open-dynamic-robot-initiative/power-board/firmware/powerboard/Core/Src/main.c

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
/* Includes ------------------------------------------------------------------*/
#include "main.h"

/* USER CODE BEGIN Includes */
#include "ws2812_bitbang.h"
#include "ina239.h"
#include "spi_com.h"
/* USER CODE END Includes */

SPI_HandleTypeDef hspi1;
SPI_HandleTypeDef hspi2;
DMA_HandleTypeDef hdma_spi1_tx;
DMA_HandleTypeDef hdma_spi1_rx;

TIM_HandleTypeDef htim3;

/* USER CODE BEGIN PV */
//                   |  8  |  8  |     16    |     16    |            32         |   16      |
//                   |0xaa | cpt |    vbus   |   vshunt  |          energy       |  CRC      |  Power board Sensor message
#define INIT_TX_BUF  {0xaa, 0xa0, 0xaa, 0xaa, 0xaa, 0xaa, 0xaa, 0xaa, 0xaa, 0xaa, 0xaa, 0x00}

//                   |  8  |  8  |     16    |     16    |    16     |    16     |   16      |
//                   |0xbb | cmd |  vbusmax  | vshuntmax |window_time|           |  CRC      |  Power board Command message
#define INIT_RX_BUF  {0xbb, 0x00, 0x00, 0x00, 0x00, 0x00, 0x00, 0x00, 0x00, 0x00, 0x00, 0x00}

//cmd:
//0x00 no command
//0x01 turn off power
//0x02 turn off power and logic
//0x03 turn on power
//0xC0-0xFF overwrite LED Color using 6bits [1 1 R R G G B B]

uint8_t TX_buffer_SPI1[12] = INIT_TX_BUF;
uint8_t RX_buffer_SPI1[12] = INIT_RX_BUF;

uint8_t sensor_frame[12] = INIT_TX_BUF;
uint8_t command_frame[12] = INIT_RX_BUF;


/* USER CODE END PV */

void SystemClock_Config(void);
static void MX_GPIO_Init(void);
static void MX_DMA_Init(void);
static void MX_SPI1_Init(void);
static void MX_SPI2_Init(void);
static void MX_TIM3_Init(void);
/**
  * @brief  The application entry point.
  * @retval int
  */
int main(void)
{
  /* MCU Configuration--------------------------------------------------------*/

  /* Reset of all peripherals, Initializes the Flash interface and the Systick. */
  HAL_Init();

  /* Configure the system clock */
  SystemClock_Config();

  /* Initialize all configured peripherals */
  MX_GPIO_Init();
  MX_DMA_Init();
  MX_SPI1_Init();
  MX_SPI2_Init();
  MX_TIM3_Init();
  /* USER CODE BEGIN 2 */
  HAL_TIM_Base_Start(&htim3);
  HAL_GPIO_WritePin(GPIOA, GPIO_PIN_3, GPIO_PIN_SET); //Enable the DC/DC converter even if user stop pressing "ON"
  HAL_Delay(100);
  HAL_GPIO_WritePin(GPIOA, GPIO_PIN_1, GPIO_PIN_SET); //Enable Power Output
  /* USER CODE END 2 */

  /* Infinite loop */
  /* USER CODE BEGIN WHILE */
  uint16_t vbus=0;
  int16_t vshunt=0;

  int16_t  vshuntValueThreshold = 25 * 800; // 25A * 800  ---  with 800=(4e-3/5e-6)=4mOhm / (5uV/LSB)  ---   40A is the maximum
  uint16_t vbusValueThreshold   = 0; //TODO
  int32_t vshuntTimeThreshold = 100*1000; //100ms
  int32_t vbusTimeThreshold   = 100*1000; //100ms

  int32_t periodVshuntAboveThreshold=0;
  int32_t periodVbusAboveThreshold=0;


  char errorOverCurrent = 0;
  char errorUnderVoltage = 0;

  union {
    float asFloat;
    unsigned char asBytes[4];
  } energy={.asFloat=0.0f};

  uint16_t time = __HAL_TIM_GET_COUNTER(&htim3);
  uint16_t time_diff = 0;
  uint16_t sample_time;
  uint16_t last_sample_time = 0;
  uint16_t dt;
  uint16_t crc;
  uint8_t red = 0;

  int i;
  uint8_t cpt=0;
  last_sample_time=__HAL_TIM_GET_COUNTER(&htim3);

  //Prepare the First SPI communication. Next ones will be triggered by the DMA IRQ
  HAL_SPI_TransmitReceive_DMA(&hspi1, TX_buffer_SPI1, RX_buffer_SPI1, 12);

  while (1) //This loop should never be executed in more that 65ms for the energy integration to stay valid
  {
	  cpt++;
	  //HAL_SPI_TransmitReceive_DMA(&hspi1, TX_buffer_SPI1, RX_buffer_SPI1, 12);
	  time_diff = __HAL_TIM_GET_COUNTER(&htim3) - time ;
	  if (time_diff >= 1000) //Blink LED in RED
	  {
		  time = __HAL_TIM_GET_COUNTER(&htim3);
		  red = 0xff * (red==0);
		  bitbangledRGB(red,0,0);
	  }
	  sample_time = __HAL_TIM_GET_COUNTER(&htim3); //time in microseconds
	  dt = sample_time - last_sample_time; //(all in uint16, so no overflow problems here)
	  last_sample_time = sample_time;
	  vbus = read_register16_INA239(hspi2,REG_INA_VBUS);
	  vshunt = -read_register16_INA239(hspi2,REG_INA_VSHUNT);
	  //power = read_register24_INA239(hspi2,REG_INA_POWER);

	  //Over current detection
	  if (vshunt > vshuntValueThreshold || vshunt < -vshuntValueThreshold)
	  {
		  periodVshuntAboveThreshold += dt;
	  }
	  else
	  {
		  if (periodVshuntAboveThreshold>dt)
		  {
			  periodVshuntAboveThreshold -= dt;
		  }
		  else
		  {
			  periodVshuntAboveThreshold = 0;
		  }
	  }
	  errorOverCurrent = (periodVshuntAboveThreshold > vshuntTimeThreshold);

	  //Under voltage detection
	  if (vbus < vbusValueThreshold)
	  {
		  periodVbusAboveThreshold += dt;
	  }
	  else
	  {
		  if (periodVbusAboveThreshold>dt)
		  {
			  periodVbusAboveThreshold -= dt;
		  }
		  else
		  {
			  periodVbusAboveThreshold = 0;
		  }
	  }
	  errorUnderVoltage = (periodVbusAboveThreshold > vbusTimeThreshold);






	  energy.asFloat = energy.asFloat + 1e-6 * dt*vbus*vshunt; //todo manage the units
	  sensor_frame[1] = cpt;
	  sensor_frame[2] = (vbus>>8)&0xff;
	  sensor_frame[3] = vbus&0xff;
	  sensor_frame[4] = (vshunt>>8)&0xff;
	  sensor_frame[5] = vshunt&0xff;
	  sensor_frame[6] = energy.asBytes[3];
	  sensor_frame[7] = energy.asBytes[2];
	  sensor_frame[8] = energy.asBytes[1];
	  sensor_frame[9] = energy.asBytes[0];
	  crc = crc16_ccitt(sensor_frame, 10);
	  sensor_frame[10] = (crc>>8)&0xff;
	  sensor_frame[11] = crc&0xff;
	  if (HAL_GPIO_ReadPin(GPIOA, GPIO_PIN_4)) //No SPI communication running, lets copy the buffers
	  {
		  for(i=1;i<12;i++)
		  {
			  TX_buffer_SPI1[i] = sensor_frame[i];
			  command_frame[i] = RX_buffer_SPI1[i];
		  }
	  }
	  //HAL_Delay(1);

    /* USER CODE END WHILE */

    /* USER CODE BEGIN 3 */
  }
  /* USER CODE END 3 */
}

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
/* USER CODE BEGIN 4 */
void HAL_GPIO_EXTI_Callback(uint16_t GPIO_Pin)
{
	if (GPIO_Pin == SPI1_CS_Pin)
	{
		if (HAL_GPIO_ReadPin(SPI1_CS_GPIO_Port,SPI1_CS_Pin) == GPIO_PIN_SET)
		{
			HAL_SPI_Abort(&hspi1);
			HAL_SPI_TransmitReceive_DMA(&hspi1, TX_buffer_SPI1, RX_buffer_SPI1, 12);
		}
	}
}




void HAL_SPI_TxRxCpltCallback(SPI_HandleTypeDef *hspi)
{
	if (hspi == &hspi1)
	{

	}
}
/* USER CODE END 4 */
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
