open-dynamic-robot-initiative/power-board/firmware/powerboard/powerboard.ioc

Mcu.UserName=STM32F103C8Tx
PD0-OSC_IN.Signal=RCC_OSC_IN
PB13.Signal=SPI2_SCK
PB15.Signal=SPI2_MOSI
PD1-OSC_OUT.Signal=RCC_OSC_OUT
PA13.Signal=SYS_JTMS-SWDIO
PA1.Signal=GPIO_Output
PB14.Signal=SPI2_MISO
PA5.Signal=SPI1_SCK
PA1.GPIO_Label=POWER_ENA
PB3.Signal=GPIO_Output
PA4.Signal=GPXTI4
PA6.Signal=SPI1_MISO
PA14.Signal=SYS_JTCK-SWCLK
PA4.GPIO_Label=SPI1_CS
PB12.Signal=GPIO_Output
PA3.GPIO_Label=DCDC_ENA
PA3.Signal=GPIO_Output
PA7.Signal=SPI1_MOSI
PB3.GPIO_Label=LED
