open-dynamic-robot-initiative/power-board/firmware/powerboard/Core/Inc/main.h

#define POWER_ENA_Pin GPIO_PIN_1
#define POWER_ENA_GPIO_Port GPIOA
#define DCDC_ENA_Pin GPIO_PIN_3
#define DCDC_ENA_GPIO_Port GPIOA
#define SPI1_CS_Pin GPIO_PIN_4
#define SPI1_CS_GPIO_Port GPIOA
#define SPI1_CS_EXTI_IRQn EXTI4_IRQn
#define LED_Pin GPIO_PIN_3
#define LED_GPIO_Port GPIOB
