open-dynamic-robot-initiative/power-board/firmware/powerboard/Core/Inc/spi_com.h

/*
 * spi_com.h
 *
 *  Created on: Jul 6, 2021
 *      Author: tflayols
 */

#ifndef SRC_SPI_COM_H_
#define SRC_SPI_COM_H_
#include <stdint.h>

uint16_t crc16_ccitt(uint8_t * data, int len);


#endif /* SRC_SPI_COM_H_ */
