open-dynamic-robot-initiative/power-board/(commit log)

2021-02-02 Add power connector and INA229
    [odri-power-board.kicad_pcb, odri-power-board.sch]
2021-02-09 add dc-dc converter
    [odri-power-board.kicad_pcb, odri-power-board.sch]
2021-02-09 WIP, Add MCU, SW, Transistor, LDO...
    [odri-power-board.kicad_pcb, odri-power-board.sch]
2021-02-09 add template, WIP..
    [odri-power-board.kicad_pcb, odri-power-board.sch]
2021-02-09 Add LTC7001 Mosfet Driver
    [odri-power-board.kicad_pcb, odri-power-board.sch]
2021-02-09 add legends, reset circuit, clean schematic, WIP..
    [odri-power-board.kicad_pcb, odri-power-board.sch]
2021-03-10 first version of complete schematic
    [odri-power-board.kicad_pcb, odri-power-board.sch]
2021-03-10 Add all footprint, wip: SWD connector, oscillator, NC E-stop
    [odri-power-board.kicad_pcb, odri-power-board.sch]
2021-03-17 Finalize SWD connector, Update MCU for dual SPI and more GPIO, wip
    [odri-power-board.kicad_pcb, odri-power-board.sch]
2021-03-17 update pcb
    [odri-power-board.kicad_pcb]
2021-03-17 add WS2812 LED
    [odri-power-board.kicad_pcb, odri-power-board.sch]
2021-03-24 continue rooting
    [odri-power-board.kicad_pcb, odri-power-board.sch]
2021-03-31 advance PCB routing
    [odri-power-board.kicad_pcb]
2021-05-17 Add component values, correct mistake in the pushbutton wirring legend
    [odri-power-board.kicad_pcb, odri-power-board.sch]
2021-05-27 add references and links to mouser
    [odri-power-board.sch]
2021-07-07 First working version of the firmware, no cmd implemented yet, only power reading
2021-07-20 fix dt computation used for integrating the power
    [main.c]
2021-09-22 WIP add references for components
    [odri-power-board.sch]
2021-09-23 Update references for all components
    [odri-power-board.kicad_pcb, odri-power-board.sch]
